superhasduper/motor-stirling-casero/README.md

# motor-stirling-casero
Los motores stirling sirven para transformar energía térmica a mecánica de forma eficiente.
Nuestro diseño busca manufacturar uno de estos motores de forma economica y viable en el menor tamaño posible.
