superhasduper/motor-stirling-casero/Definitivo Copia_Acople jeringa 2 (1).stl

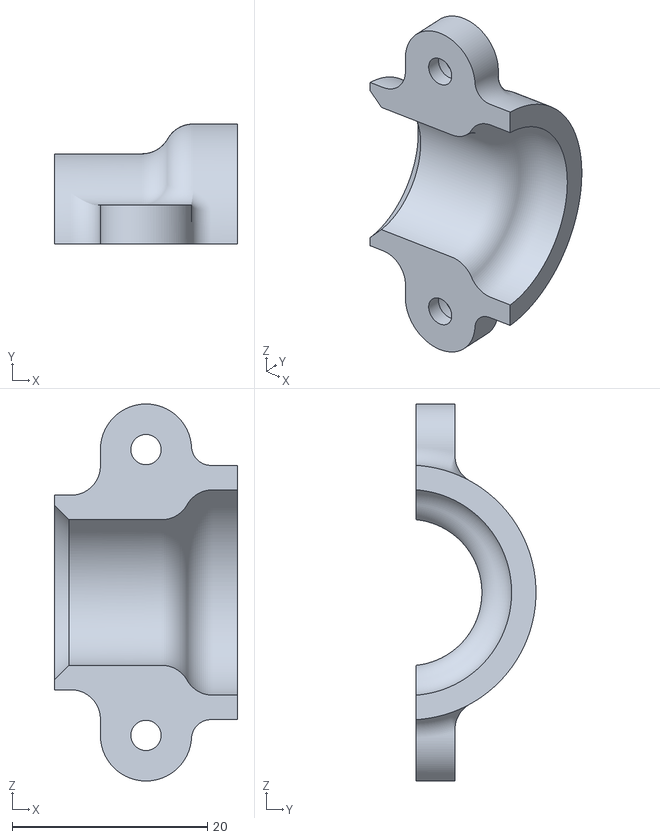
[picture p31: CAD file, 2022-11-14]
Definitivo Copia_Acople jeringa 2 (1).stl
18.8 x 12.3 x 38.6
