superhasduper/motor-stirling-casero/Definitivo Copia_Biela 1.stl

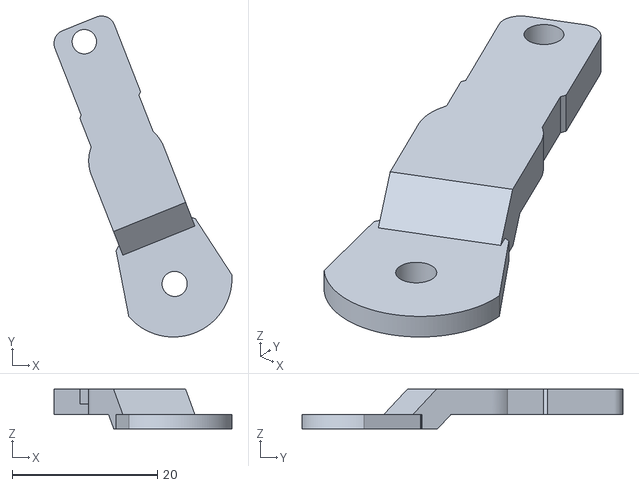
[picture p32: CAD file, 2022-11-14]
Definitivo Copia_Biela 1.stl
24.5 x 44.2 x 5.50
