superhasduper/motor-stirling-casero/Definitivo Copia_Cigüeñal .stl

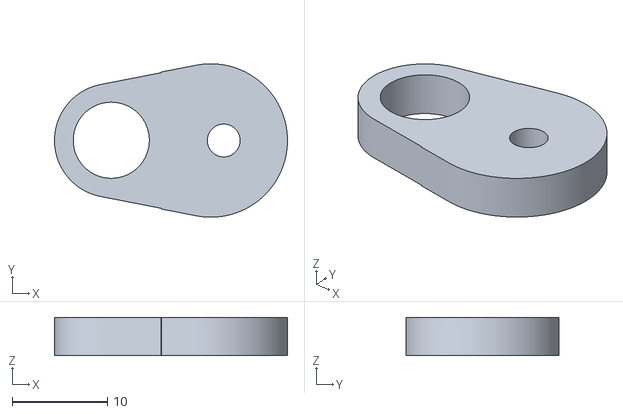
[picture p33: CAD file, 2022-11-14]
Definitivo Copia_Cigüeñal .stl
24.5 x 16.1 x 4.00
