superhasduper/motor-stirling-casero/Definitivo Copia_Biela 2.stl

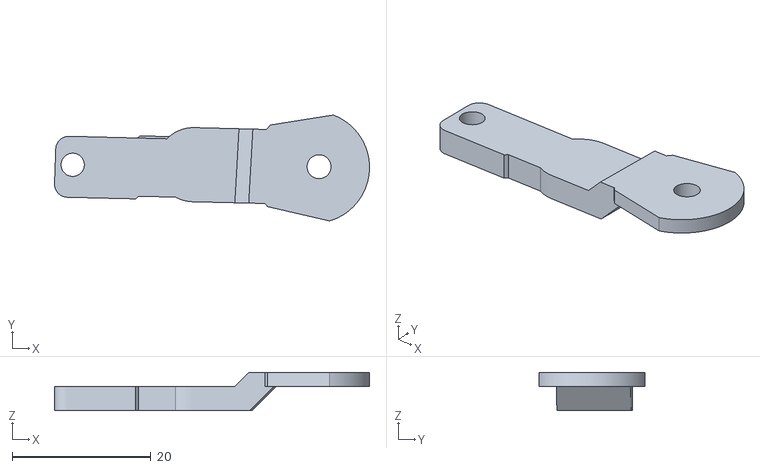
[picture p34: CAD file, 2022-11-14]
Definitivo Copia_Biela 2.stl
45.5 x 15.3 x 5.50
