superhasduper/motor-stirling-casero/Definitivo Copia_Pasador 7,5mm .stl

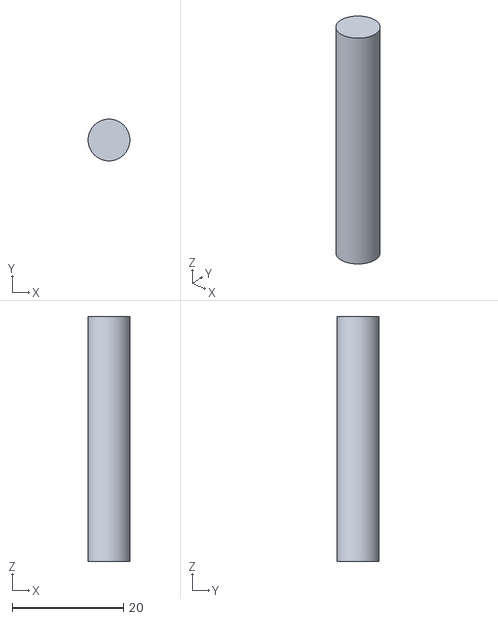
[picture p35: CAD file, 2022-11-14]
Definitivo Copia_Pasador 7,5mm .stl
7.50 x 7.50 x 44.0
