superhasduper/motor-stirling-casero/Definitivo Copia_Tapa .stl

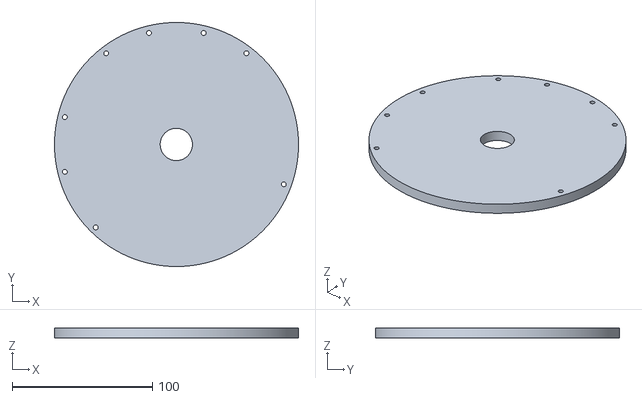
[picture p36: CAD file, 2022-11-14]
Definitivo Copia_Tapa .stl
174.0 x 174.0 x 7.10
