superhasduper/motor-stirling-casero/Definitivo Copia_Rueda de inercia.stl

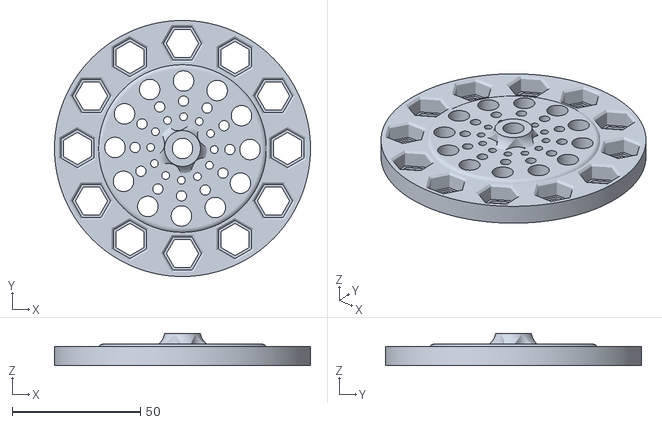
[picture p37: CAD file, 2022-11-14]
Definitivo Copia_Rueda de inercia.stl
100.0 x 100.0 x 12.5
