superhasduper/motor-stirling-casero/Definitivo Copia_Acople jeringa 1 (2).stl

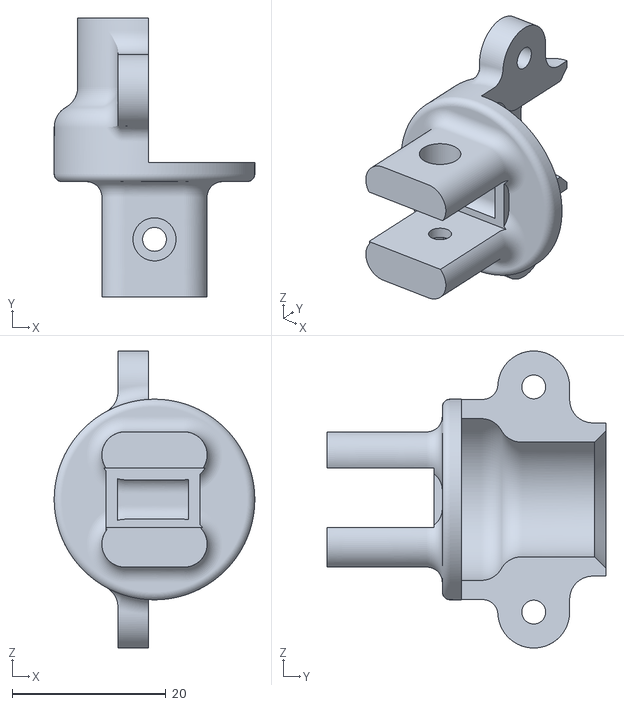
[picture p38: CAD file, 2022-11-14]
Definitivo Copia_Acople jeringa 1 (2).stl
26.1 x 36.3 x 38.6
