superhasduper/motor-stirling-casero/Definitivo Copia_Soporte jeringa 2.stl

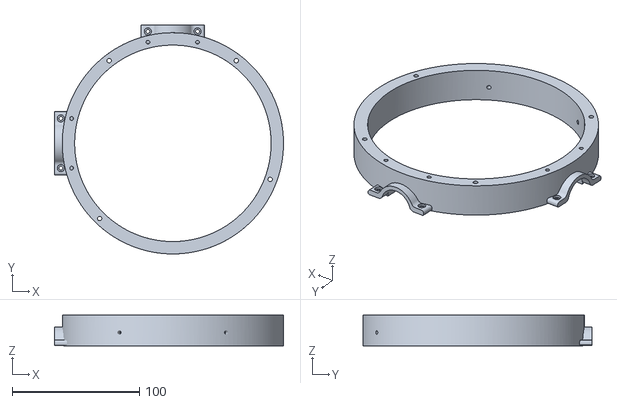
[picture p39: CAD file, 2022-11-14]
Definitivo Copia_Soporte jeringa 2.stl
180.1 x 180.0 x 24.1
