superhasduper/motor-stirling-casero/Definitivo Copia_Soporte motor.stl

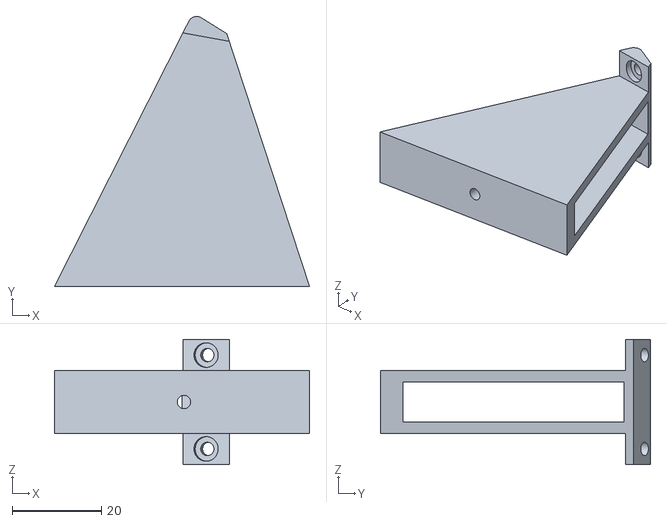
[picture p40: CAD file, 2022-11-14]
Definitivo Copia_Soporte motor.stl
57.1 x 60.4 x 28.0
