superhasduper/motor-stirling-casero/Definitivo Copia_Pasador 7,5mm  (1).stl

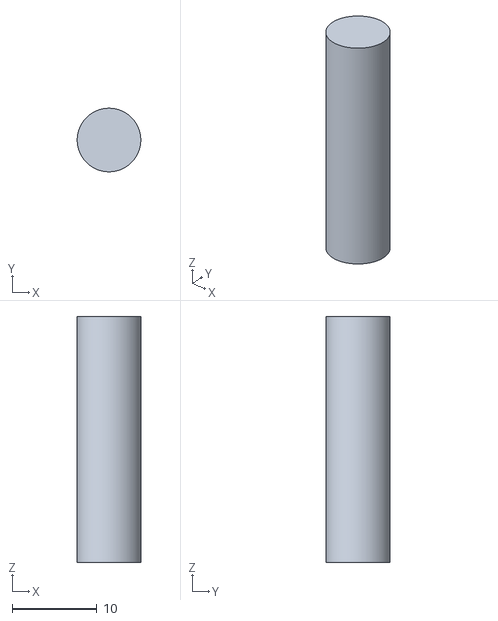
[picture p41: CAD file, 2022-11-14, an earlier design]
Definitivo Copia_Pasador 7,5mm (1).stl
7.50 x 7.50 x 29.0
