superhasduper/motor-stirling-casero/Definitivo Copia_Tapa  (1).stl

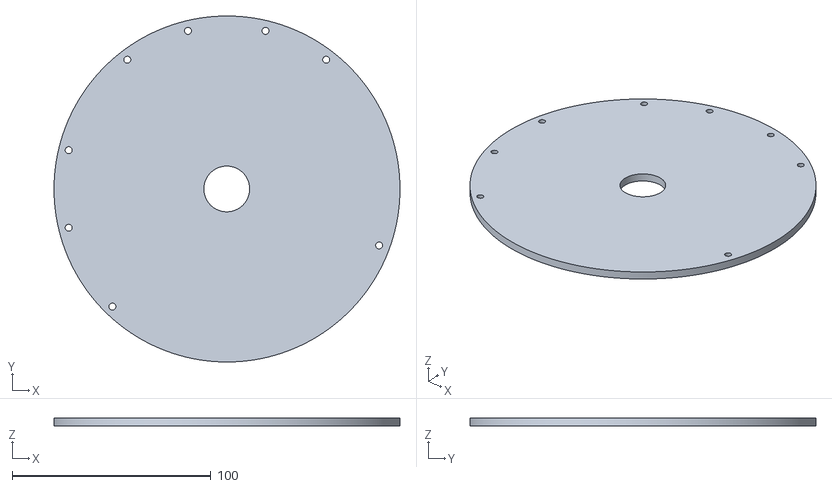
[picture p42: CAD file, 2022-11-14, an earlier design]
Definitivo Copia_Tapa (1).stl
174.0 x 174.0 x 4.10
