superhasduper/motor-stirling-casero/(list of files, cad)

Other CAD files:
Definitivo Copia_Acople jeringa 2 (2).stl
Definitivo Copia_Acople jeringa 1 (1).stl
Definitivo Copia_Cigüeñal (2).stl
Definitivo Copia_Soporte jeringa 2 (1).stl
Definitivo Copia_Soporte motor (1).stl
