superhasduper/motor-stirling-casero/(commit log)

2022-11-14 Update README.md
    Añadido de información
2022-11-14 Archivos 3d del motor
    El motor utiliza tuercas M12 para la rueda de inercia. Y tuercas y tornillos M3 para su ensamblaje. Los pistones don jeringuillas de cristal de 10ml.
    [Definitivo Copia_Acople jeringa 1 (1).stl, Definitivo Copia_Acople jeringa 1 (2).stl, Definitivo Copia_Acople jeringa 2 (1).stl, Definitivo Copia_Acople jeringa 2 (2).stl, Definitivo Copia_Biela 1.stl, Definitivo Copia_Biela 2.stl, Definitivo Copia_Cigüeñal (2).stl, Definitivo Copia_Cigüeñal .stl]
2022-12-15 Add files via upload
    PDF del motor y vídeo del motor
